diegohmacias/always-winning-plinko/documentation/always-winning-plinko-proposal.pdf

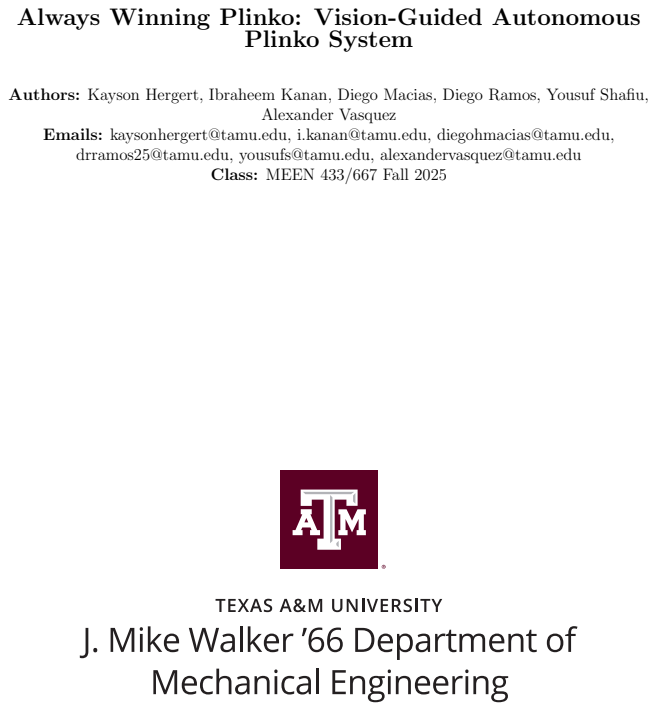
[picture p1: page 1]
Plinko System; Alexander Vasquez

Always Winning Plinko: Vision-Guided Autonomous

Authors: Kayson Hergert, Ibraheem Kanan, Diego Macias, Diego Ramos, Yousuf Shafiu,

Emails: kaysonhergert@tamu.edu, i.kanan@tamu.edu, diegohmacias@tamu.edu,
drramos25@tamu.edu, yousufs@tamu.edu, alexandervasquez@tamu.edu

Class: MEEN 433/667 Fall 2025

### 1. Objective and Significance

### 1.1. Project Goal

The objective of this project is to design and build an autonomous Plinko game featuring a vision-guided, motorized catcher. A single mobile catcher at the bottom of the exit will serve as the only winning slot. The system will use a front-mounted camera to track a falling ball in real-time, controlling the catcher’s linear position to intercept it and create an “always-win” experience. The core of the project is the seamless integration of computer vision, real-time control systems, and electromechanical actuation to solve a time-critical interception problem. The primary goal is to demonstrate a system in which vision-based sensing enables dynamic actuation, requiring the catcher to accurately position itself before the ball arrives, with no opportunity for correction after a miss.

### 1.2. Technical Significance

This project addresses several critical engineering challenges that are representative of realworld robotic applications.

- Latency-Constrained Interception: The system must make time-critical decisions. Vision processing introduces inherent delays, which requires the control system to act on outdated information without a second chance to catch the ball. A response delay of even 50 milliseconds could result in a failure, making optimization of the entire processing pipeline essential.
- Trajectory Uncertainty: Collisions between the ball and the pegs introduce significant randomness, making the ball’s path unpredictable from its initial conditions alone. This demands a robust, real-time tracking and prediction system rather than a simple pre-calculated trajectory. A stationary catcher would fail, as the ball’s exit position varies with each drop.
- Dynamic Actuation: The motor must accelerate the catcher from a resting state to the correct position within a very tight timing window, demanding a control system that balances high speed with positional accuracy.

These challenges are directly applicable to industrial automation, such as high-speed pickand-place systems, conveyor belt sorting, and robotic interception problems such as drone catching systems.

### 2. Design Concept

### 2.1. System Overview

The system consists of an open-front Plinko board viewed by a tripod-mounted camera. A Raspberry Pi 4 will perform vision processing using OpenCV to detect and track the ball. The ball’s coordinates will be sent to an Arduino Uno, which will run a PID control loop to manage a motorized linear rail positioned at the board’s bottom exit. The camera’s pixel coordinates will be mapped to the board’s physical coordinates using a homography transformation calibrated with markers.

### 2.2. Mechanical and Electrical Design

The Plinko board and pegs will be 3D printed. The catcher assembly will be a 3D-printed cup mounted on a belt-driven linear rail, actuated by a geared DC motor with an encoder for position feedback. The camera will be mounted on a tripod to maintain a fixed position for consistent calibration. Electronics will be separated into distinct power domains for the Raspberry Pi and motor systems. An L298N H-bridge will drive the motor, controlled by the Arduino. Safety is paramount; in addition to firmware-based travel limits and physical end stops, a hardware emergency stop (E-stop) button will be implemented to provide a robust physical override that cuts power to the motor.

### 2.3. Control and Software Concept

The control architecture uses the Raspberry Pi for high-level vision processing and the Arduino for low-level motor control. The vision software will use HSV color-based detection to identify the ball’s centroid at over 30 frames per second. These pixel coordinates are transformed into the board’s coordinate system (in mm) and sent to the Arduino via a oneway serial connection. The Arduino will use this position as the setpoint for a PID controller, which uses encoder feedback to drive the catcher motor and intercept the ball. Initially, the catcher will directly track the ball’s horizontal position; predictive algorithms may be added if system latency proves too high for this simple approach.

### 2.4. Representative Diagrams

The proposed system architecture and preliminary mechanical designs are shown below. It is important to note that the CAD models are conceptual and will be refined during the development phase. The dimensions provided are preliminary and may change.
The overall data and control flow is illustrated in Figure 1.

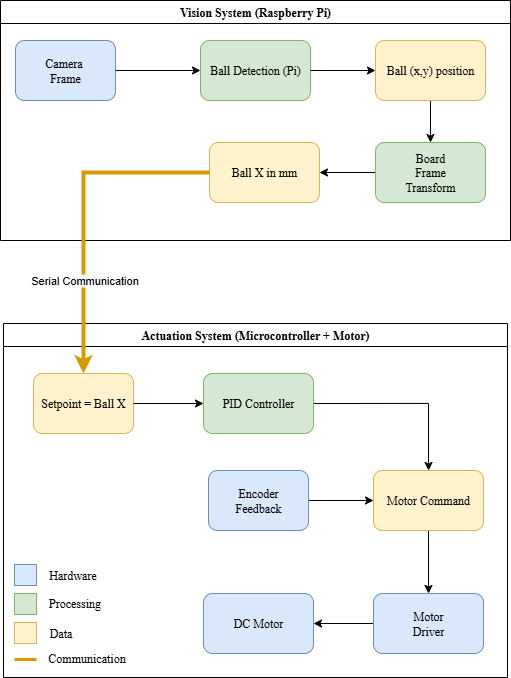
[picture p2: figure]

Figure 1: The system architecture, showing the data flow from vision to actuation.

A preliminary mechanical layout is provided in Figure 2, with initial dimensions detailed in Table 1.

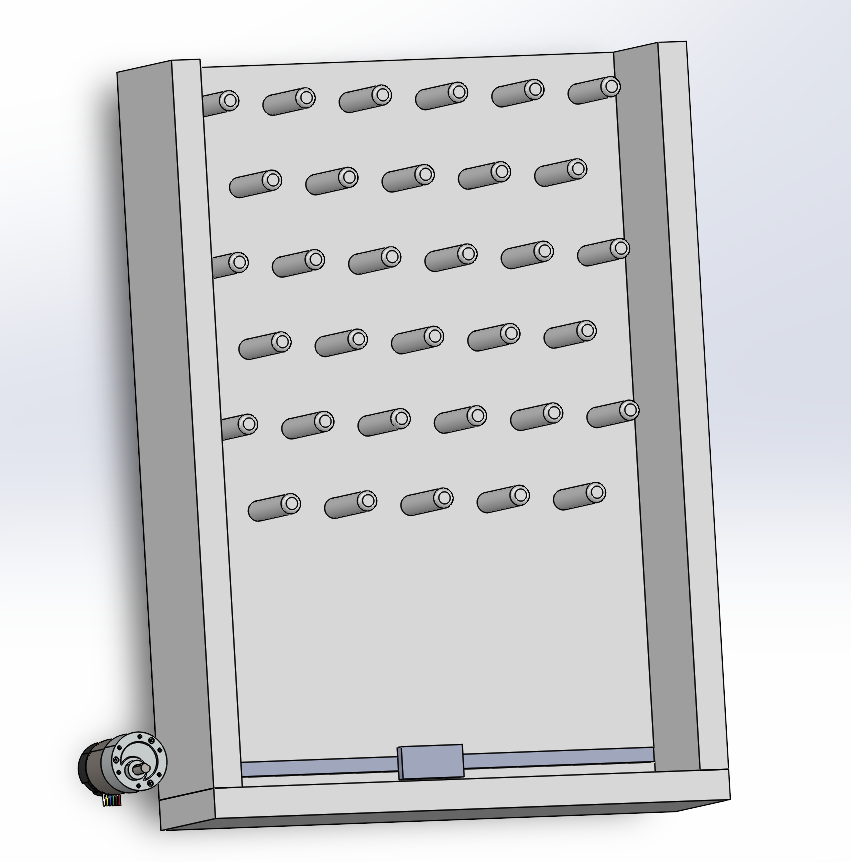
[picture p3: figure]

Figure 2: Preliminary mechanical concept of the Plinko board.

Table 1: Preliminary Mechanical Dimensions of the Plinko Board
Parameter | Value (mm)
Overall Board Height | 457.2
Overall Board Width | 304.8
Peg Field Height | 266.7
Peg Field Width | 266.7
Ball Diameter | 25 - 40 (TBD)
Peg Diameter | 12.7
Horizontal Peg Spacing 50.8 Vertical Peg Spacing 50.8

The core of the actuation system is a belt-driven linear rail. While the final design is in development, it will be based on the concept shown in Figure 3. A preliminary CAD model of the catcher is shown in Figure 4.

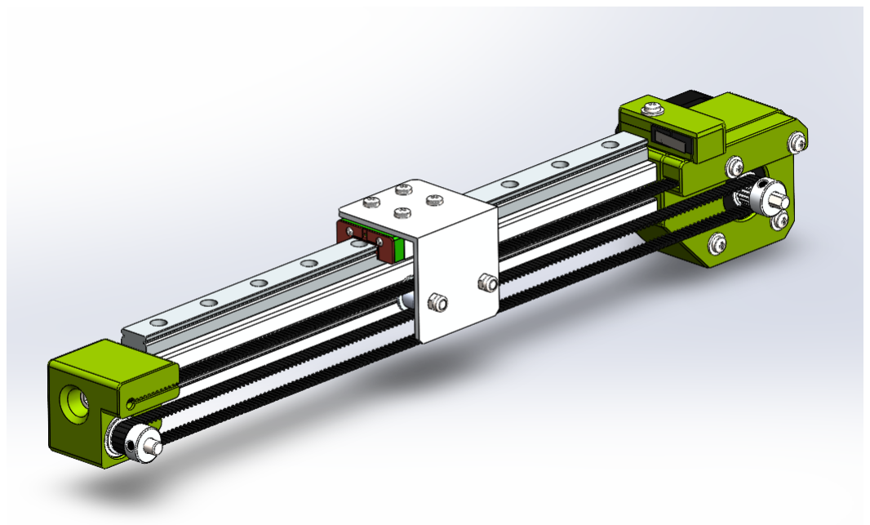
[picture p4: figure]

Figure 3: Reference image for the belt-driven linear rail concept.

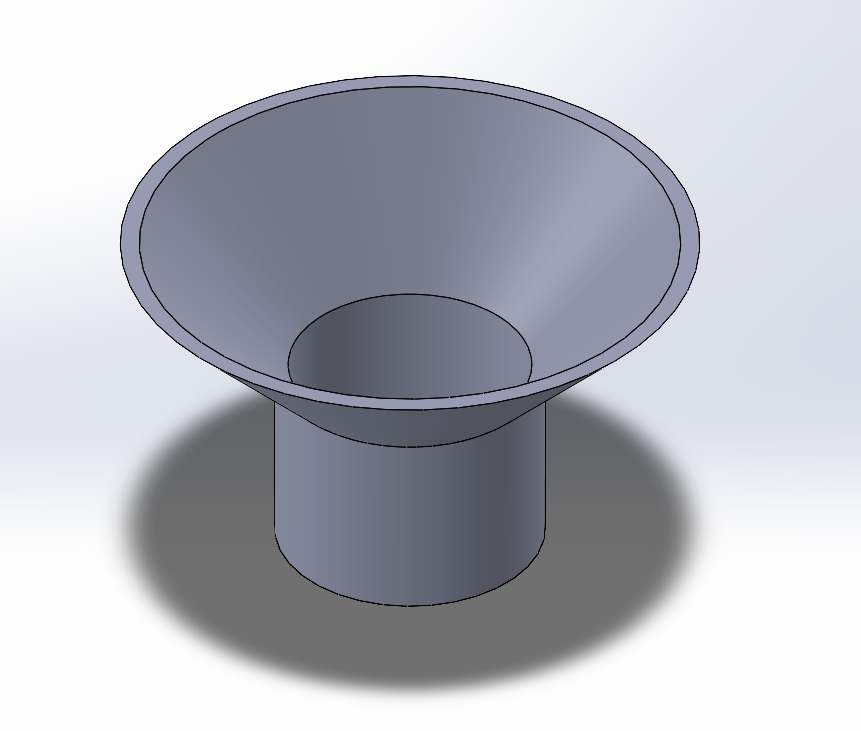
[picture p5: figure]

Figure 4: Preliminary 3D design of the catcher.

The electrical design, which includes the planned E-stop integration, is shown in Figure 5.

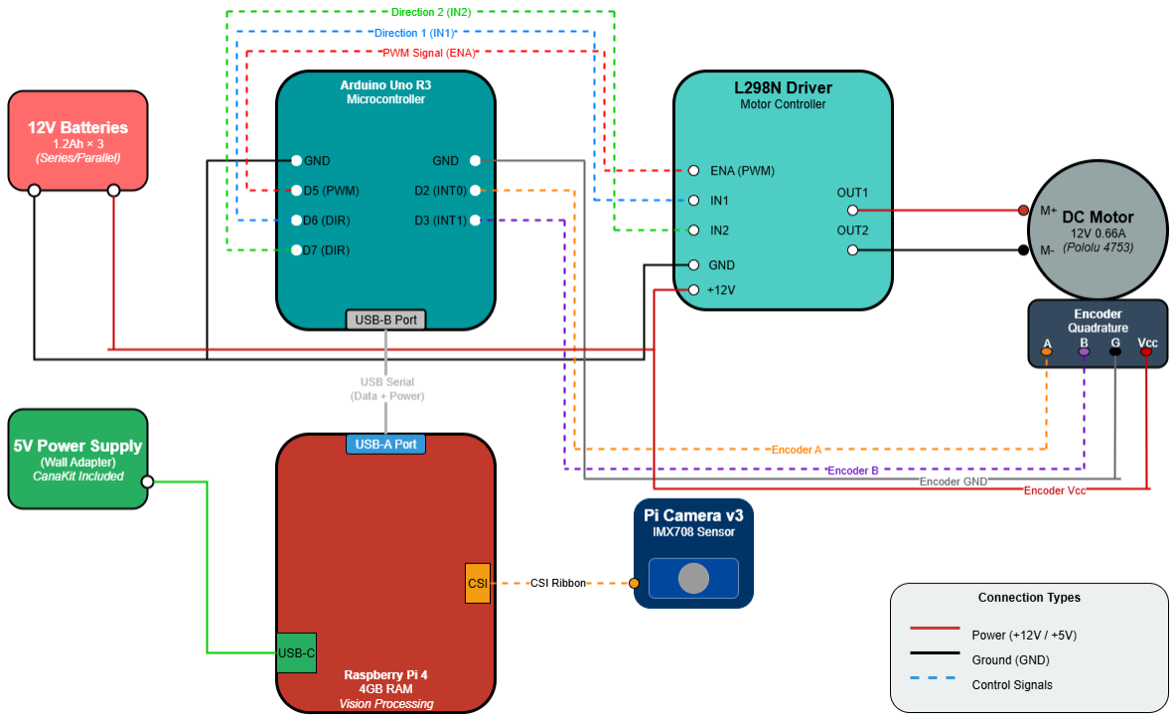
[picture p6: figure]

Figure 5: Circuit diagram showing power and control connections for the actuation system.

### 3. Work Plan

The project will be executed in three parallel workstreams followed by a final integration and testing phase.

1. Subsystem Development:
- Mechanical: Finalize the board and catcher design, fabricate all components using 3D printing, and assemble the linear rail, belt drive, motor, and catcher assembly.
- Electrical: Finalize motor and driver selection, design the power distribution and safety circuits (including E-stop), and wire all electronic components for integration testing.
- Software: Develop and validate the vision pipeline for reliable ball detection, implement the camera calibration routine for coordinate transformation, and establish serial communication protocols.
2. System Integration:
- Assemble the complete mechanical and electrical system.
- Establish and debug the serial communication link between the Raspberry Pi and Arduino.

- Combine the vision software and motor control firmware into a complete, end-toend system for initial tests.
3. Testing and Refinement:
- Conduct static and dynamic tests to measure key performance metrics, including system latency and catch success rate.
- Tune the PID controller for smooth, accurate, and fast catcher motion.
- Based on baseline performance, a decision will be made on whether to implement state prediction algorithms to improve performance.

The project is scheduled to be completed by the final demonstration on December 3rd, 2025. The timeline is structured to complete subsystem development by the end of October, followed by integration in early November, leaving ample time for testing, optimization, and documentation. A detailed breakdown of all tasks, team responsibilities, and deadlines is provided in the Gantt chart located in the Appendix (see Figure 6).

### 4. Budget and Justification

The total budget allocated for this project is $500.00. The current cost for specified components is $376.09, leaving a remaining budget of $123.91.
This remaining budget is critical for the completion of the mechanical systems. It will be allocated to 3D printing services for the finalized board and enclosures, as well as for purchasing any additional hardware needed for the linear rail system. This may include items such as v-slot aluminum extrusions, fasteners, and additional pulleys once the design is finalized. The budget breakdown is summarized in Table 2.

Table 2: Budget Allocation Summary
Category | Cost
Mechanical Components (Preliminary) | $47.96
Electrical Components | $103.42
Software & Vision Components | $224.71
Total Purchased Items | $376.09

Remaining for Mechanical Finalization $123.91

Total Project Budget | $500.00

### 5. Anticipated Results

The primary deliverable will be a fully functional autonomous Plinko game that demonstrates the “always-win” concept by successfully intercepting the falling ball. The project’s success will be evaluated based on the target metrics detailed in Table 3.

Table 3: Target Performance Metrics
Metric | Target | Measurement Method
Ball Detection Accuracy | > 95% | Count detections vs. actual drops over 50
| | trials
System Latency | < 100 ms Timestamp from image capture to motor
| | response
Catcher Positioning Accuracy | ±5 mm | Compare commanded vs. actual encoder po-
| | sition
Overall Catch Success Rate > 70% | Successful catches / total attempts
| | over 50+ drops

The project will be considered a success if the system operates safely, achieves a catch success rate exceeding 70% over 50+ trials, integrates all subsystems seamlessly, and is completed within the $500 budget. The project will exceed expectations if the catch rate surpasses 85% or if predictive control algorithms are successfully implemented and proven to enhance performance.

### A. Project Timeline Gantt Chart

The complete project timeline is detailed in the Gantt chart below (Figure 6). This chart outlines all major tasks, dependencies, and deadlines for the mechanical, electrical, and software teams.

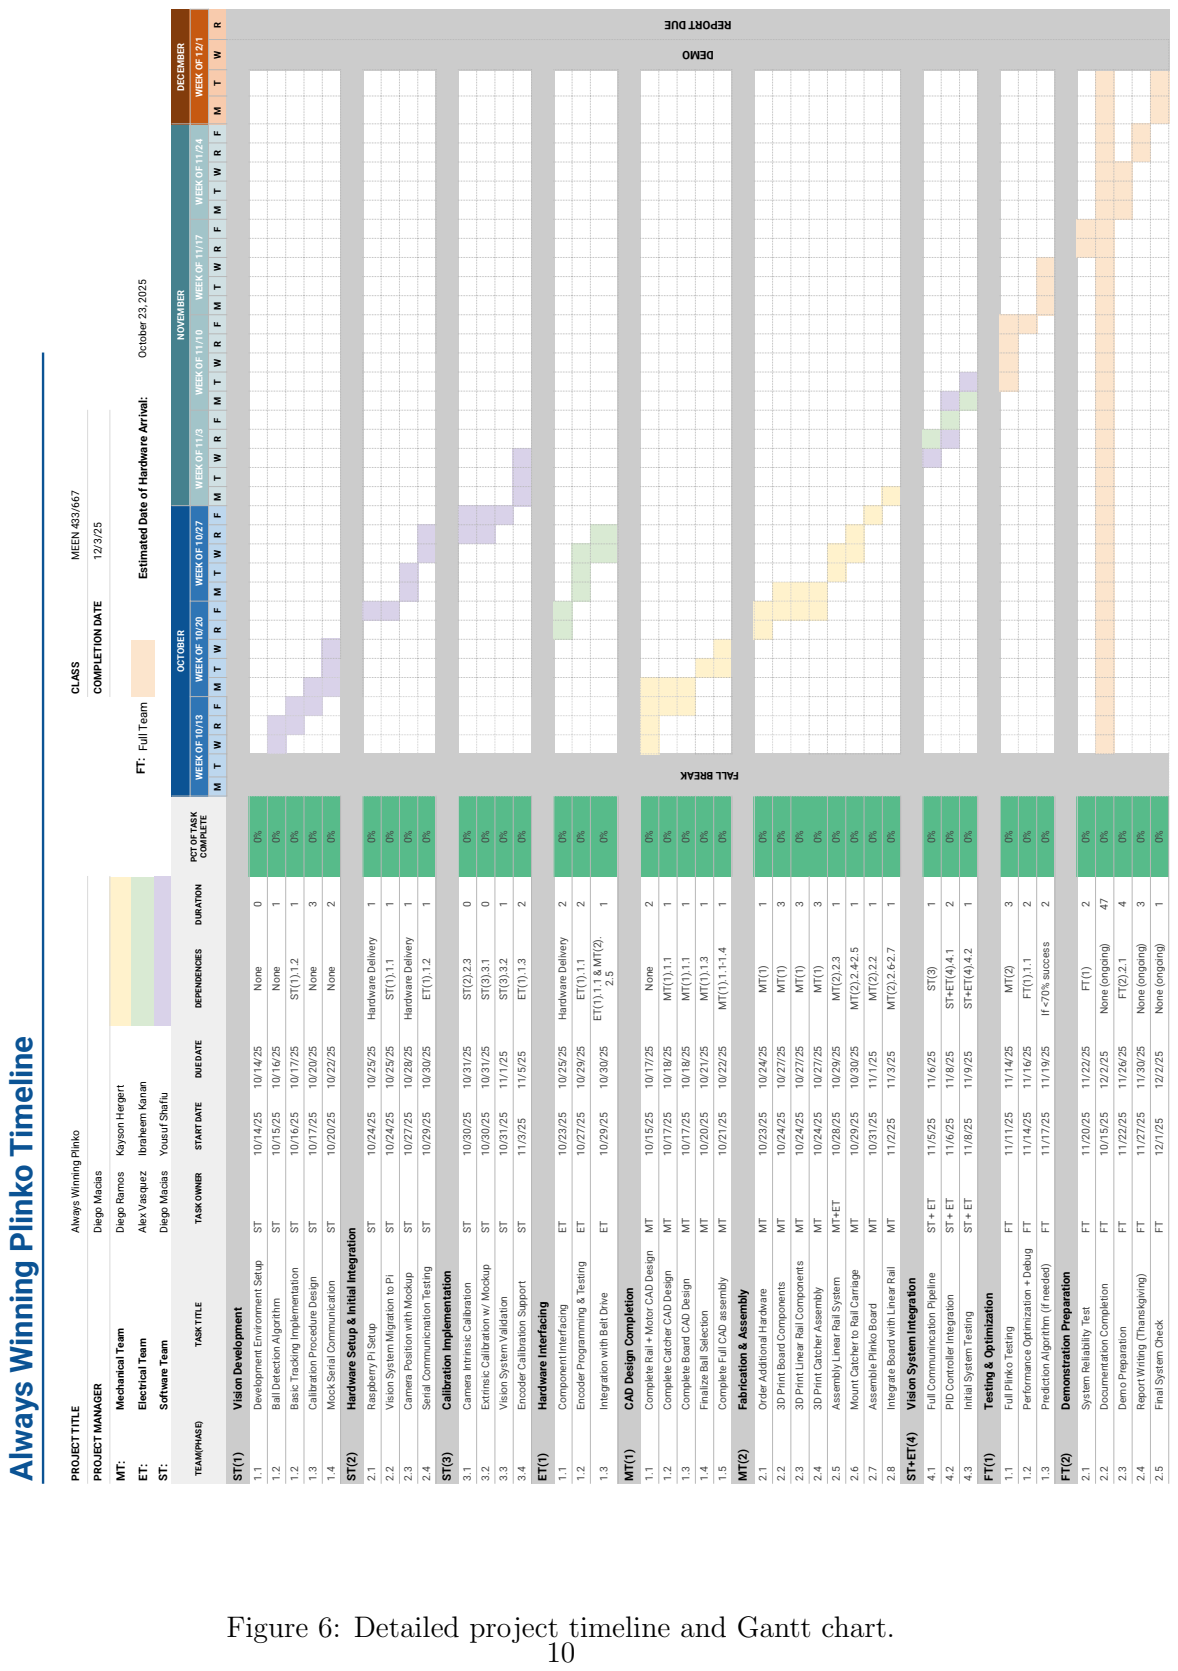
[picture p7: page 11]

OCTOBER NOVEMBER DECEMBER WEEK OF 10/13 WEEK OF 10/20 WEEK OF 10/27 WEEK OF 11/3 WEEK OF 11/10 WEEK OF 11/17 WEEK OF 11/24 WEEK OF 12/1 M T W R F M T W R F M T W R F M T W R F M T W R F M T W R F M T W R F M T W R

FT: ET: Electrical Team Alex Vasquez Ibraheem Kanan Full Team Estimated Date of Hardware Arrival: October 23, 2025

PROJECT TITLE Always Winning Plinko CLASS MEEN 433/667

PROJECT MANAGER Diego Macias COMPLETION DATE 12/3/25 MT: Mechanical Team Diego Ramos Kayson Hergert

TEAM(PHASE) TASK TITLE TASK OWNER START DATE DUE DATE DEPENDENCIES DURATION PCT OF TASK COMPLETE

1.1 Development Environment Setup ST 10/14/25 10/14/25 None 0 0%

1.2 Ball Detection Algorithm ST 10/15/25 10/16/25 None 1 0%

1.2 Basic Tracking Implementation ST 10/16/25 10/17/25 ST(1).1.2 1 0%

1.3 Calibration Procedure Design ST 10/17/25 10/20/25 None 3 0%

1.4 Mock Serial Communication ST 10/20/25 10/22/25 None 2 0%

2.1 Raspberry Pi Setup ST 10/24/25 10/25/25 Hardware Delivery 1 0%

2.2 Vision System Migration to Pi ST 10/24/25 10/25/25 ST(1).1.1 1 0%

2.3 Camera Position with Mockup ST 10/27/25 10/28/25 Hardware Delivery 1 0%

2.4 Serial Communicnation Testing ST 10/29/25 10/30/25 ET(1).1.2 1 0%

3.1 Camera Intrinsic Calibration ST 10/30/25 10/31/25 ST(2).2.3 0 0%

3.2 Extrinsic Calibration w/ Mockup ST 10/30/25 10/31/25 ST(3).3.1 0 0%

3.3 Vision System Validation ST 10/31/25 11/1/25 ST(3).3.2 1 0%

3.4 Encoder Calibration Support ST 11/3/25 11/5/25 ET(1).1.3 2 0%

1.1 Component Interfacing ET 10/23/25 10/25/25 Hardware Delivery 2 0%

1.2 Encoder Programming & Testing ET 10/27/25 10/29/25 ET(1).1.1 2 0%

1.3 Integration with Belt Drive ET 10/29/25 10/30/25 ET(1).1.1 & MT(2). 2.5 1 0%

1.1 Complete Rail + Motor CAD Design MT 10/15/25 10/17/25 None 2 0%

1.2 Complete Catcher CAD Design MT 10/17/25 10/18/25 MT(1).1.1 1 0%

1.3 Complete Board CAD Design MT 10/17/25 10/18/25 MT(1).1.1 1 0%

1.4 Finalize Ball Selection MT 10/20/25 10/21/25 MT(1).1.3 1 0%

1.5 Complete Full CAD assembly MT 10/21/25 10/22/25 MT(1).1.1-1.4 1 0% MT(2) Fabrication & Assembly

2.1 Order Additional Hardware MT 10/23/25 10/24/25 MT(1) 1 0%

2.2 3D Print Board Components MT 10/24/25 10/27/25 MT(1) 3 0%

2.3 3D Print Linear Rail Components MT 10/24/25 10/27/25 MT(1) 3 0%

2.4 3D Print Catcher Assembly MT 10/24/25 10/27/25 MT(1) 3 0%

2.5 Assembly Linear Rail System MT+ET 10/28/25 10/29/25 MT(2).2.3 1 0%

2.6 Mount Catcher to Rail Carriage MT 10/29/25 10/30/25 MT(2).2.4-2.5 1 0%

2.7 Assemble Plinko Board MT 10/31/25 11/1/25 MT(2).2.2 1 0%

2.8 Integrate Board with Linear Rail MT 11/2/25 11/3/25 MT(2).2.6-2.7 1 0%

4.1 Full Communincation Pipeline ST + ET 11/5/25 11/6/25 ST(3) 1 0%

4.2 PID Controller Integration ST + ET 11/6/25 11/8/25 ST+ET(4).4.1 2 0%

4.3 Initial System Testing ST + ET 11/8/25 11/9/25 ST+ET(4).4.2 1 0%

1.1 Full Plinko Testing FT 11/11/25 11/14/25 MT(2) 3 0%

1.2 Performance Optimization + Debug FT 11/14/25 11/16/25 FT(1).1.1 2 0%

1.3 Prediction Algorithm (if needed) FT 11/17/25 11/19/25 If <70% success 2 0%

2.1 System Reliability Test FT 11/20/25 11/22/25 FT(1) 2 0%

2.2 Documentation Completion FT 10/15/25 12/2/25 None (ongoing) 47 0%

2.3 Demo Preparation FT 11/22/25 11/26/25 FT(2).2.1 4 0%

2.4 Report Writing (Thanskgiving) FT 11/27/25 11/30/25 None (ongoing) 3 0%

2.5 Final System Check FT 12/1/25 12/2/25 None (ongoing) 1 0%

Always Winning Plinko Timeline

ST: Software Team Diego Macias Yousuf Shafiu

ST(2) Hardware Setup & Initial Integration

ST(3) Calibration Implementation

ST+ET(4) Vision System Integration

FT(2) Demonstration Preparation

MT(1) CAD Design Completion

FT(1) Testing & Optimization

ST(1) Vision Development

ET(1) Hardware Interfacing

Figure 6: Detailed project timeline and Gantt chart.
