diegohmacias/always-winning-plinko/documentation/ElectricalCircuitDiagram.png

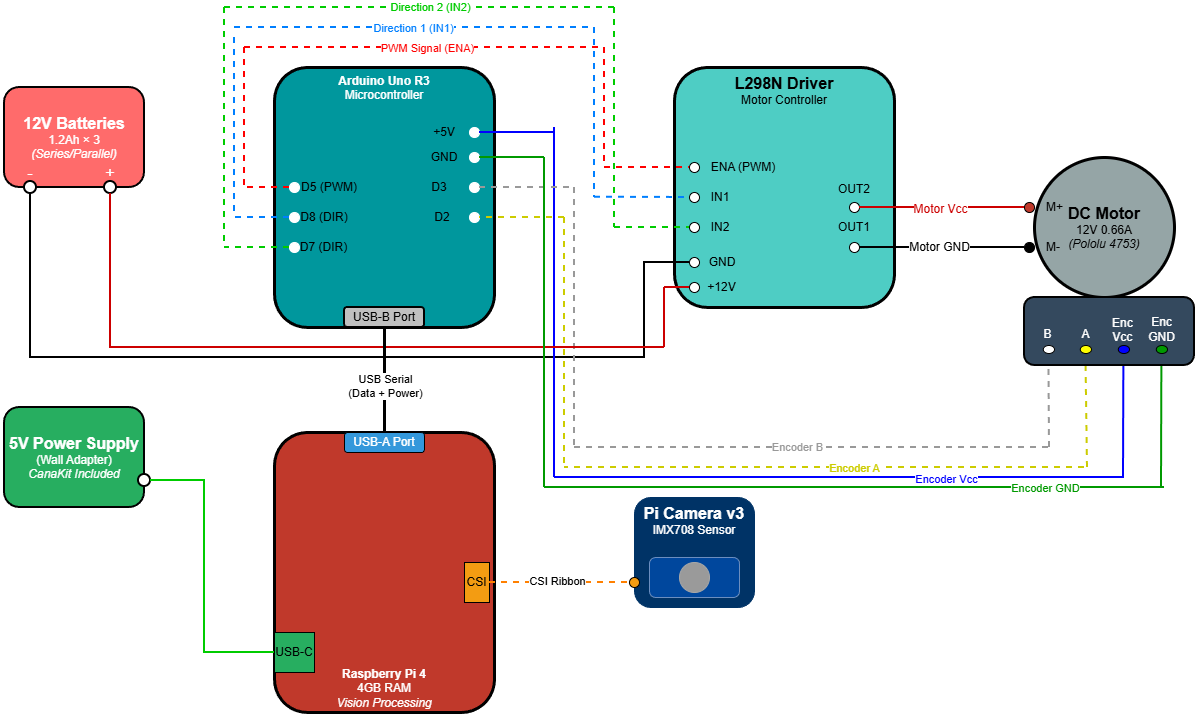
documentation/ElectricalCircuitDiagram.png
