diegohmacias/always-winning-plinko/(commit log)

2025-11-20 add: arduino scripts
2025-11-20 add: electrical wiring diagram of system
2025-11-27 modify: calibration script
2025-11-27 add: instructions for arduino calibration
2025-12-02 mod: changed board dimensions to match real system
2025-12-02 mod: added homing functionality
